delfisalinasmich/sistema-apertura-cajones/cad/README.md

# CAD

Acá van los archivos CAD/STL de la pieza impresa en 3D (soporte del brazo con el servo + sujeción del imán, montado sobre la base giratoria) cuando estén listos. Ver [pieza-3d.md](../docs/pieza-3d.md).
