delfisalinasmich/sistema-apertura-cajones/test/mocks/esp32servo_mock.cpp

#include "ESP32Servo.h"

static int anguloActual = 0;
static int pinActual = -1;

void Servo::setPeriodHertz(int) {}

void Servo::attach(int pin) {
  pinActual = pin;
}

void Servo::attach(int pin, int, int) {
  pinActual = pin;
}

void Servo::write(int angulo) {
  anguloActual = angulo;
}

int mock_anguloServo() {
  return anguloActual;
}

int mock_pinServo() {
  return pinActual;
}
