delfisalinasmich/sistema-apertura-cajones/(commit log)

2026-09-01 Firmware inicial: máquina de estados de la rutina autónoma, simulable con LEDs y botones en ESP32
    Compilado y verificado con arduino-cli (esp32:esp32:esp32).
2026-09-01 Modo manual vía interfaz web (Access Point) + endpoint /pedido
    - servidor_web: AP propio (CajonesBot), página con controles de X/vástago y pedido de columna, polling de estado.
    - modo: MODO_MANUAL/MODO_AUTONOMO a nivel de sistema, separado de la FSM de la rutina.
    - maquina_estados: solicitarPedido() como punto de entrada único (botón físico o /pedido web); vuelve solo a modo manual al terminar la rutina o resetear una emergencia.
    - Parada de emergencia se mantiene físico-only, a propósito.
    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
    [maquina_estados.cpp, maquina_estados.h, modo.cpp, modo.h, servidor_web.h]
2026-09-01 Tests automáticos de la máquina de estados (sin ESP32)
    - test/: compila los .cpp de producción (motores, sensores, seguridad, modo, maquina_estados) con un mock mínimo de las primitivas de Arduino, y corre 5 escenarios: estado inicial, ciclo autónomo completo, pedido ignorado con rutina en curso, prioridad de la emergencia, y antirrebote real.
    - Encontraron un bug real: sensores_iniciar() no reseteaba el estado de antirrebote de los botones (quedaba pegado si un botón no se soltaba antes de un reinicio). Corregido.
    - 24/24 tests en verde. Recompilado y verificado igual con arduino-cli.
    [Arduino.h, arduino_mock.cpp, test_maquina_estados.cpp]
2026-09-01 Contraseña real del AP + fix de seguridad en el botón de pedido
    - AP_PASSWORD pasa de valor de prueba a AbreCajon26.
    - src.ino: el botón físico de pedido se leía por nivel, no por flanco. Como
    resetear una parada de emergencia exige mantenerlo presionado, el robot
    podía arrancar solo una rutina autónoma apenas se reseteaba la emergencia.
    Ahora se lee por flanco.
    Verificado con test/run_tests.sh (24/24) y arduino-cli compile.
2026-10-20 Rediseño a 3 motores reales: ruedas X, servo de línea, brazo Z
    El mecanismo cambió respecto al diseño original (riel + vástago con ranura
    bayoneta). El grupo armó físicamente un robot de 2 ruedas con un brazo de
    2 motores: uno adelante-atrás que engancha el imán y abre el cajón al
    retroceder, y un servo que orienta el brazo hacia una segunda línea de
    cajones. Esto da 3 GDL reales (X, rotación de línea, Z) sin inventar nada
    artificial, y de paso elimina la ranura bayoneta, que era la pieza de mayor
    riesgo de fabricación de todo el proyecto.
    - maquina_estados: nuevos estados ORIENTANDO_LINEA y ABRIENDO (reemplaza
    ROTANDO_APERTURA), se elimina RETRAYENDO_Z (ahora abrir y retrae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
2026-10-21 Migrar el firmware a PlatformIO sobre el hardware real armado por Coty
    El mecanismo que había armado en el repo estaba adivinado desde fotos y
    tenía la asignación de actuadores al revés: asumía un motor DC para la
    apertura y un servo para la orientación. El hardware real (proyecto
    PlatformIO de Coty, con una secuencia mecánica ya probada físicamente) es
    al revés: un micro servo avanza el brazo hasta que el imán toca una tuerca
    metálica y vuelve despacio tirando (eso abre el cajón); una base giratoria
    con motor DC + reductora, movida por pulsos de tiempo contra topes
    mecánicos (sin sensor), orienta el brazo hacia un lado. El sensor de
    columna tampoco es un módulo digital: es un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
2026-10-21 Incorporar respuestas de Coty: pendientes resueltos + mapeo de pines a confirmar
    Coty contestó las preguntas pendientes sobre el hardware real:
    - Resuelto: resistencia de 10kΩ del sensor ya soldada (calibración guardada),
    servo alimentado desde el 5V del puente H, asimetría de pulsos de la base
    confirmada repetible, el imán sí se suelta solo con los ángulos actuales,
    L298N alcanza con margen para ambos motores, no hay filas adicionales (el
    "lado" ya cubre el tercer GDL, la columna se resuelve con rueda + sensor),
    home confirmado como la primera columna/marca.
    - Pendiente nuevo, no resuelto: la calibración de pulsos de la base solo se
    probó yendo hacia un lado (a propó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
